wehrend/vocoder-pico-hardware/vocoder-pico-hardware.csv

ID+ADs-Bezeichner+ADs-Footprint+ADs-St+//3//Q-ckzahl+ADs-Bezeichnung+ADs-Anbieter und Referenz
1+ADs-SW2,SW1+ADs-SW+AF8-PUSH+AF8-6mm+ADs-2+ADs-SW+AF8-Push+ADs-
2+ADs-C10+ADs-C+AF8-Disc+AF8-D5.0mm+AF8-W2.5mm+AF8-P5.00mm+ADs-1+ADs-1u+ADs-
3+ADs-R4+ADs-R+AF8-0805+AF8-2012Metric+ADs-1+ADs-6.8k+ADs-
4+ADs-U6,U4,U5,U7+ADs-Sx39+AC0-1xxxxx+ADs-4+ADs-SC39+AC0-11GWA+ADs-
5+ADs-C17,C9,C12,C25+ADs-C+AF8-0805+AF8-2012Metric+ADs-4+ADs-10uF+ADs-
6+ADs-U8+ADs-DIP+AC0-8+AF8-W7.62mm+AF8-Socket+ADs-1+ADs-TL072+ADs-
7+ADs-J3,J2+ADs-Jack+AF8-3.5mm+AF8-QingPu+AF8-WQP+AC0-PJ398SM+AF8-Vertical+AF8-CircularHoles+ADs-2+ADs-AudioJack2+AF8-SwitchT+ADs-
8+ADs-R23,R1,R24+ADs-R+AF8-0805+AF8-2012Metric+ADs-3+ADs-10k+ADs-
9+ADs-C22,C15,C28,C14+ADs-C+AF8-0805+AF8-2012Metric+ADs-4+ADs-0.1uf+ADs-
10+ADs-R7+ADs-R+AF8-0805+AF8-2012Metric+ADs-1+ADs-470Ohm+ADs-
11+ADs-C26+ADs-C+AF8-0805+AF8-2012Metric+ADs-1+ADs-2.2nF+ADs-
12+ADs-U3+ADs-TSSOP+AC0-20+AF8-4.4x6.5mm+AF8-P0.65mm+ADs-1+ADs-PCM5100A+ADs-
13+ADs-RV2,RV1+ADs-Potentiometer+AF8-Alpha+AF8-RD901F+AC0-40+AC0-00D+AF8-Single+AF8-Vertical+ADs-2+ADs-B10K lin+ADs-
14+ADs-R22+ADs-R+AF8-0805+AF8-2012Metric+ADs-1+ADs-1k+ADs-
15+ADs-C19,C20+ADs-C+AF8-0805+AF8-2012Metric+ADs-2+ADs-2.2uf+ADs-
16+ADs-C1,C5,C18,C2+ADs-C+AF8-Disc+AF8-D5.0mm+AF8-W2.5mm+AF8-P5.00mm+ADs-4+ADs-100n+ADs-
17+ADs-C11,C7+ADs-C+AF8-Disc+AF8-D5.0mm+AF8-W2.5mm+AF8-P5.00mm+ADs-2+ADs-100p+ADs-
18+ADs-MK1+ADs-INMP441+AF8-Module+AF8-Socket+ADs-1+ADs-INMP441+AF8-Module+ADs-
19+ADs-R5,R9,R20,R19,R18+ADs-R+AF8-Axial+AF8-DIN0207+AF8-L6.3mm+AF8-D2.5mm+AF8-P7.62mm+AF8-Horizontal+ADs-5+ADs-1k+ADs-
20+ADs-C16+ADs-C+AF8-Disc+AF8-D5.0mm+AF8-W2.5mm+AF8-P5.00mm+ADs-1+ADs-10u+ADs-
21+ADs-U1+ADs-DIP+AC0-8+AF8-W7.62mm+AF8-Socket+ADs-1+ADs-MCP6002+AC0-xP+ADs-
22+ADs-C13+ADs-C+AF8-Disc+AF8-D5.0mm+AF8-W2.5mm+AF8-P5.00mm+ADs-1+ADs-4.7n+ADs-
23+ADs-R21+ADs-R+AF8-0805+AF8-2012Metric+ADs-1+ADs-30k+ADs-
24+ADs-R25+ADs-R+AF8-0805+AF8-2012Metric+ADs-1+ADs-100k+ADs-
25+ADs-U2+ADs-TO+AC0-220+AC0-3+AF8-Vertical+ADs-1+ADs-LM7805+AF8-TO220+ADs-
26+ADs-R17,R13,R14,R16,R11,R10,R12,R15+ADs-R+AF8-Axial+AF8-DIN0207+AF8-L6.3mm+AF8-D2.5mm+AF8-P7.62mm+AF8-Horizontal+ADs-8+ADs-220+ADs-
27+ADs-C6,C3,C4+ADs-CP+AF8-Radial+AF8-D5.0mm+AF8-P2.00mm+ADs-3+ADs-22uF+ADs-
28+ADs-D1,D2,D3+ADs-D+AF8-DO+AC0-41+AF8-SOD81+AF8-P10.16mm+AF8-Horizontal+ADs-3+ADs-1N5817+ADs-
29+ADs-Q3,Q1,Q4,Q2+ADs-TO+AC0-92+AF8-Inline+ADs-4+ADs-BC547+ADs-
30+ADs-J1+ADs-IDC+AC0-Header+AF8-2x05+AF8-P2.54mm+AF8-Vertical+ADs-1+ADs-Conn+AF8-02x05+AF8-Odd+AF8-Even+ADs-
31+ADs-+ADs-female header 1x20 RM2.54+ADs-2+ADs-+ADs-
