wehrend/vocoder-pico-hardware/panel/frontplatte_vorschau.png

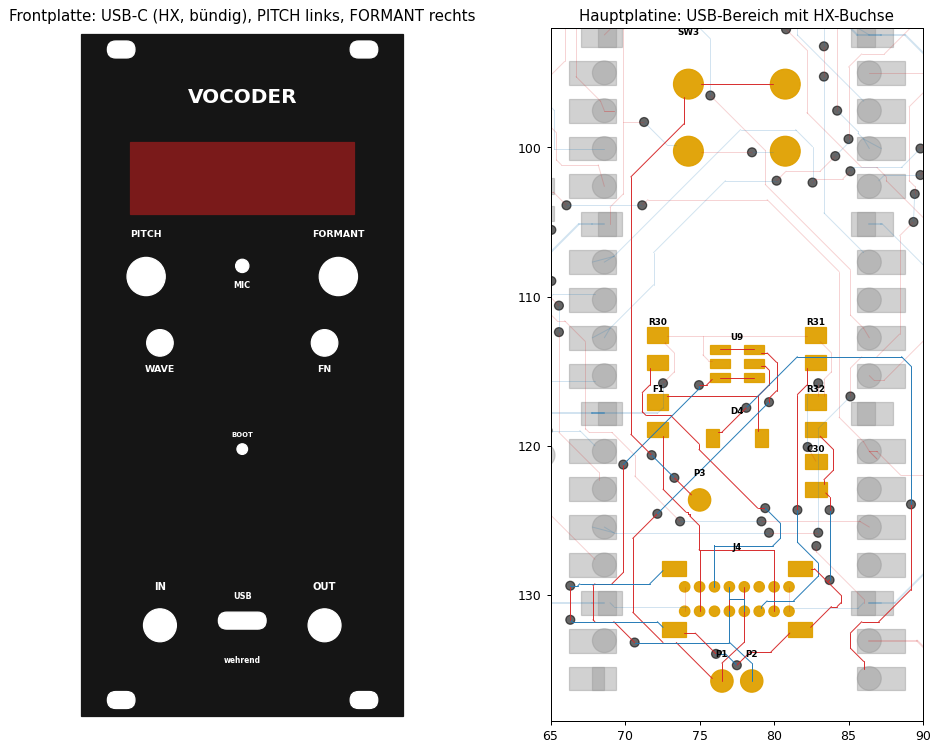
panel/frontplatte_vorschau.png
