wehrend/vocoder-pico-hardware/vocoder-pico-hardware_BOM.xlsx

 |  |  | Vocoder Pico Hardware v1.0 (12HP Eurorack) – BOM per board
Item # | *Designator | *Qty | Manufacturer | *Mfg Part # | Description / Value | *Package/Footprint | Type | Your Instructions / Notes
1 | U3 | 1 | Texas Instruments | PCM5100APWR | IC AUDIO DAC STEREO 32-BIT 384KHZ 2VRMS | TSSOP-20 | SMD | Check pin 1 orientation
2 | C9,C12,C17,C25 | 4 | Samsung | CL21A106KAYNNNE | CAP CER 10UF 25V X5R 0805 | 0805 | SMD | Equivalent X5R/X7R ≥10V acceptable
3 | C14,C15,C22,C28 | 4 | Samsung | CL21B104KBCNNNC | CAP CER 100NF 50V X7R 0805 | 0805 | SMD | Equivalent X7R acceptable
4 | C19,C20 | 2 | Samsung | CL21A225KAFNNNE | CAP CER 2.2UF 25V X5R 0805 | 0805 | SMD | DAC charge pump; equivalent X5R/X7R ≥10V acceptable
5 | C26 | 1 | Samsung | CL21C222JBFNNNE | CAP CER 2.2NF 50V C0G/NP0 0805 | 0805 | SMD | C0G/NP0 required (audio filter)
6 | R1,R23,R24 | 3 | Yageo | RC0805FR-0710KL | RES 10K OHM 1% 1/8W 0805 | 0805 | SMD
7 | R4 | 1 | Yageo | RC0805FR-076K8L | RES 6.8K OHM 1% 1/8W 0805 | 0805 | SMD
8 | R7 | 1 | Yageo | RC0805FR-07470RL | RES 470 OHM 1% 1/8W 0805 | 0805 | SMD
9 | R21 | 1 | Yageo | RC0805FR-0730KL | RES 30K OHM 1% 1/8W 0805 | 0805 | SMD
10 | R22 | 1 | Yageo | RC0805FR-071KL | RES 1K OHM 1% 1/8W 0805 | 0805 | SMD
11 | R25 | 1 | Yageo | RC0805FR-07100KL | RES 100K OHM 1% 1/8W 0805 | 0805 | SMD
12 | C1,C2,C5,C18 | 4 | Vishay | K104K15X7RF53L2 | CAP CER 100NF 50V X7R RADIAL | Radial P5.0mm | thru-hole
13 | C7,C11 | 2 | Vishay | K101J15C0GF53L2 | CAP CER 100PF 50V C0G/NP0 RADIAL | Radial P5.0mm | thru-hole | C0G/NP0 required (op-amp feedback)
14 | C10 | 1 | Murata | RDER71H105K2M1H03A | CAP CER 1UF 50V X7R RADIAL | Radial P5.0mm | thru-hole
15 | C13 | 1 | Vishay | K472K15X7RF53L2 | CAP CER 4.7NF 50V X7R RADIAL | Radial P5.0mm | thru-hole
16 | C16 | 1 | Murata | RDEC71H106K3M1H03A | CAP CER 10UF 50V RADIAL | Radial P5.0mm | thru-hole
17 | C3,C4,C6 | 3 | Panasonic | EEU-FM1H220 | CAP ALUM 22UF 50V RADIAL D5mm | Radial D5.0mm P2.0mm | thru-hole | Polarized – observe + marking; mounted on bottom side
18 | R5,R9,R18,R19,R20 | 5 | Yageo | MFR-25FRF52-1K | RES 1K OHM 1% 1/4W AXIAL METAL FILM | Axial DIN0207 P7.62mm | thru-hole
19 | R10,R11,R12,R13,R14,R15,R16,R17 | 8 | Yageo | MFR-25FRF52-220R | RES 220 OHM 1% 1/4W AXIAL METAL FILM | Axial DIN0207 P7.62mm | thru-hole
20 | D1,D2,D3 | 3 | STMicroelectronics | 1N5817 | DIODE SCHOTTKY 20V 1A DO-41 | DO-41 P10.16mm | thru-hole | Polarized – cathode band per silkscreen; mounted on bottom side
21 | Q1,Q2,Q3,Q4 | 4 | onsemi | BC547BTF | TRANS NPN 45V 100MA TO-92 | TO-92 inline | thru-hole | Mounted on bottom side; pinout C-B-E
22 | U2 | 1 | STMicroelectronics | L7805CV | IC REG LINEAR 5V 1.5A TO-220 | TO-220-3 vertical | thru-hole | Mounted on bottom side
23 | SW1,SW2 | 2 | Omron | B3F-1060 | SWITCH TACTILE SPST-NO 6X6MM | 6x6mm THT | thru-hole | Actuator height must suit front panel (cap)
24 | U4,U5,U6,U7 | 4 | Kingbright | SC39-11SURKWA | DISPLAY 7-SEG 1 DIGIT 10MM HYPER RED CC | Sx39-1xxxxx | thru-hole
25 | J1 | 1 | Würth Elektronik | 61201021621 | CONN BOX HEADER 2X5 2.54MM VERTICAL | IDC 2x05 P2.54mm | thru-hole | Eurorack power; mounted on bottom side; -12V at pin 1 (silkscreen)
26 | H3,H4 | 2 | Mill-Max | 110-43-308-41-001000 | SOCKET IC DIP-8 PRECISION | DIP-8 W7.62mm | thru-hole | DIP-8 sockets; no own footprint – solder into U1/U8 positions
27 | U1 | 1 | Microchip | MCP6002-I/P | IC OPAMP DUAL RAIL-TO-RAIL 1MHZ DIP-8 | DIP-8 | thru-hole | Insert into socket, do not solder
28 | U8 | 1 | Texas Instruments | TL072CP | IC OPAMP DUAL JFET DIP-8 | DIP-8 | thru-hole | Insert into socket, do not solder
29 | H1,H2 | 2 | generic | Female header 1x20 RM2.54 | CONN FEMALE HEADER 1X20 2.54MM VERTICAL | 1x20 P2.54mm | thru-hole | Two 1x20 female headers, one per pin row of A1 (Pico socket); no own footprint – solder into A1 pin rows
30 | J2,J3 | 2 | Thonk / QingPu | WQP-PJ398SM | JACK 3.5MM MONO SWITCHED VERTICAL (Thonkiconn) | PJ398SM vertical | thru-hole | Align with front panel before soldering
31 | RV1,RV2 | 2 | Alpha | RD901F-40 B10K | POT 9MM VERTICAL 10K LINEAR, M7 BUSHING | Alpha RD901F-40-00D | thru-hole | Shaft type to match knobs; align with front panel before soldering
32 | MK1 | 1 | generic | INMP441 breakout module | I2S MEMS MICROPHONE MODULE | INMP441 module 2x3 | thru-hole | Sound port side facing front panel
33 | J4 | 1 | Hanxia | HX-TYPE-C 16P 180 LC-B H10.0 | CONN USB-C RECEPTACLE 16P VERTICAL THT H10mm (LCSC C49261584) | USB-C vertical THT | thru-hole | Front side, bottom centre; opening towards front panel
34 | U9 | 1 | STMicroelectronics | USBLC6-2SC6 | TVS DIODE ARRAY ESD USB 2 LINES | SOT-23-6 | SMD | Check pin 1 orientation
35 | D4 | 1 | onsemi | MBR0520LT1G | DIODE SCHOTTKY 20V 0.5A | SOD-123 | SMD | Polarized – cathode band per silkscreen
36 | F1 | 1 | Bourns | MF-PSMF050X-2 | PTC RESETTABLE FUSE 0.5A HOLD | 0805 | SMD | Equivalent 0805 PTC 0.5A hold acceptable
37 | R30,R31 | 2 | Yageo | RC0805FR-075K1L | RES 5.1K OHM 1% 1/8W 0805 | 0805 | SMD | USB-C CC pull-downs
38 | R32 | 1 | Yageo | RC0805FR-071ML | RES 1M OHM 1% 1/8W 0805 | 0805 | SMD
39 | C30 | 1 | Samsung | CL21B472KBANNNC | CAP CER 4.7NF 50V X7R 0805 | 0805 | SMD | Equivalent X7R acceptable
40 | SW3 | 1 | Omron | B3F-1060 | SWITCH TACTILE SPST-NO 6X6MM (BOOTSEL) | 6x6mm THT | thru-hole | Pressed through small front panel hole
41 | P1,P2,P3 | 3 | generic | P50 spring probe | SPRING TEST PROBE P50, ROUND/FLAT HEAD | Ø0.68mm probe | thru-hole | Inserted into R50 receptacles; must reach Pico test pads TP2/TP3/TP6 (~11 mm)
42 | H5,H6,H7 | 3 | generic | R50 receptacle | RECEPTACLE FOR P50 PROBE | Ø1.0mm hole | thru-hole | No own footprint – solder into P1–P3, bottom side
43 | A1 | 1 | Raspberry Pi | Raspberry Pi Pico H | MICROCONTROLLER MODULE RP2040 WITH HEADERS | Pico module | DNS | Do not stuff – plugged into female headers by customer
Need a quick and accurante quote? Need an efficient production? Please read SMT Ordering Necessary Files & Info in 1 minute. Thank you very much! (https://www.pcbway.com/smt_ordering_guide.html)
Click for Instructions on How to Create a BOM (https://www.pcbway.com/blog/PCB_Assembly/How_to_Build_a_BOM__Bill_Of_Materials_.html)
