wehrend/vocoder-pico-hardware/vocoder-pico-hardware.kicad_pcb

## KiCad design vocoder-pico-hardware.kicad_pcb (2026-10-19)

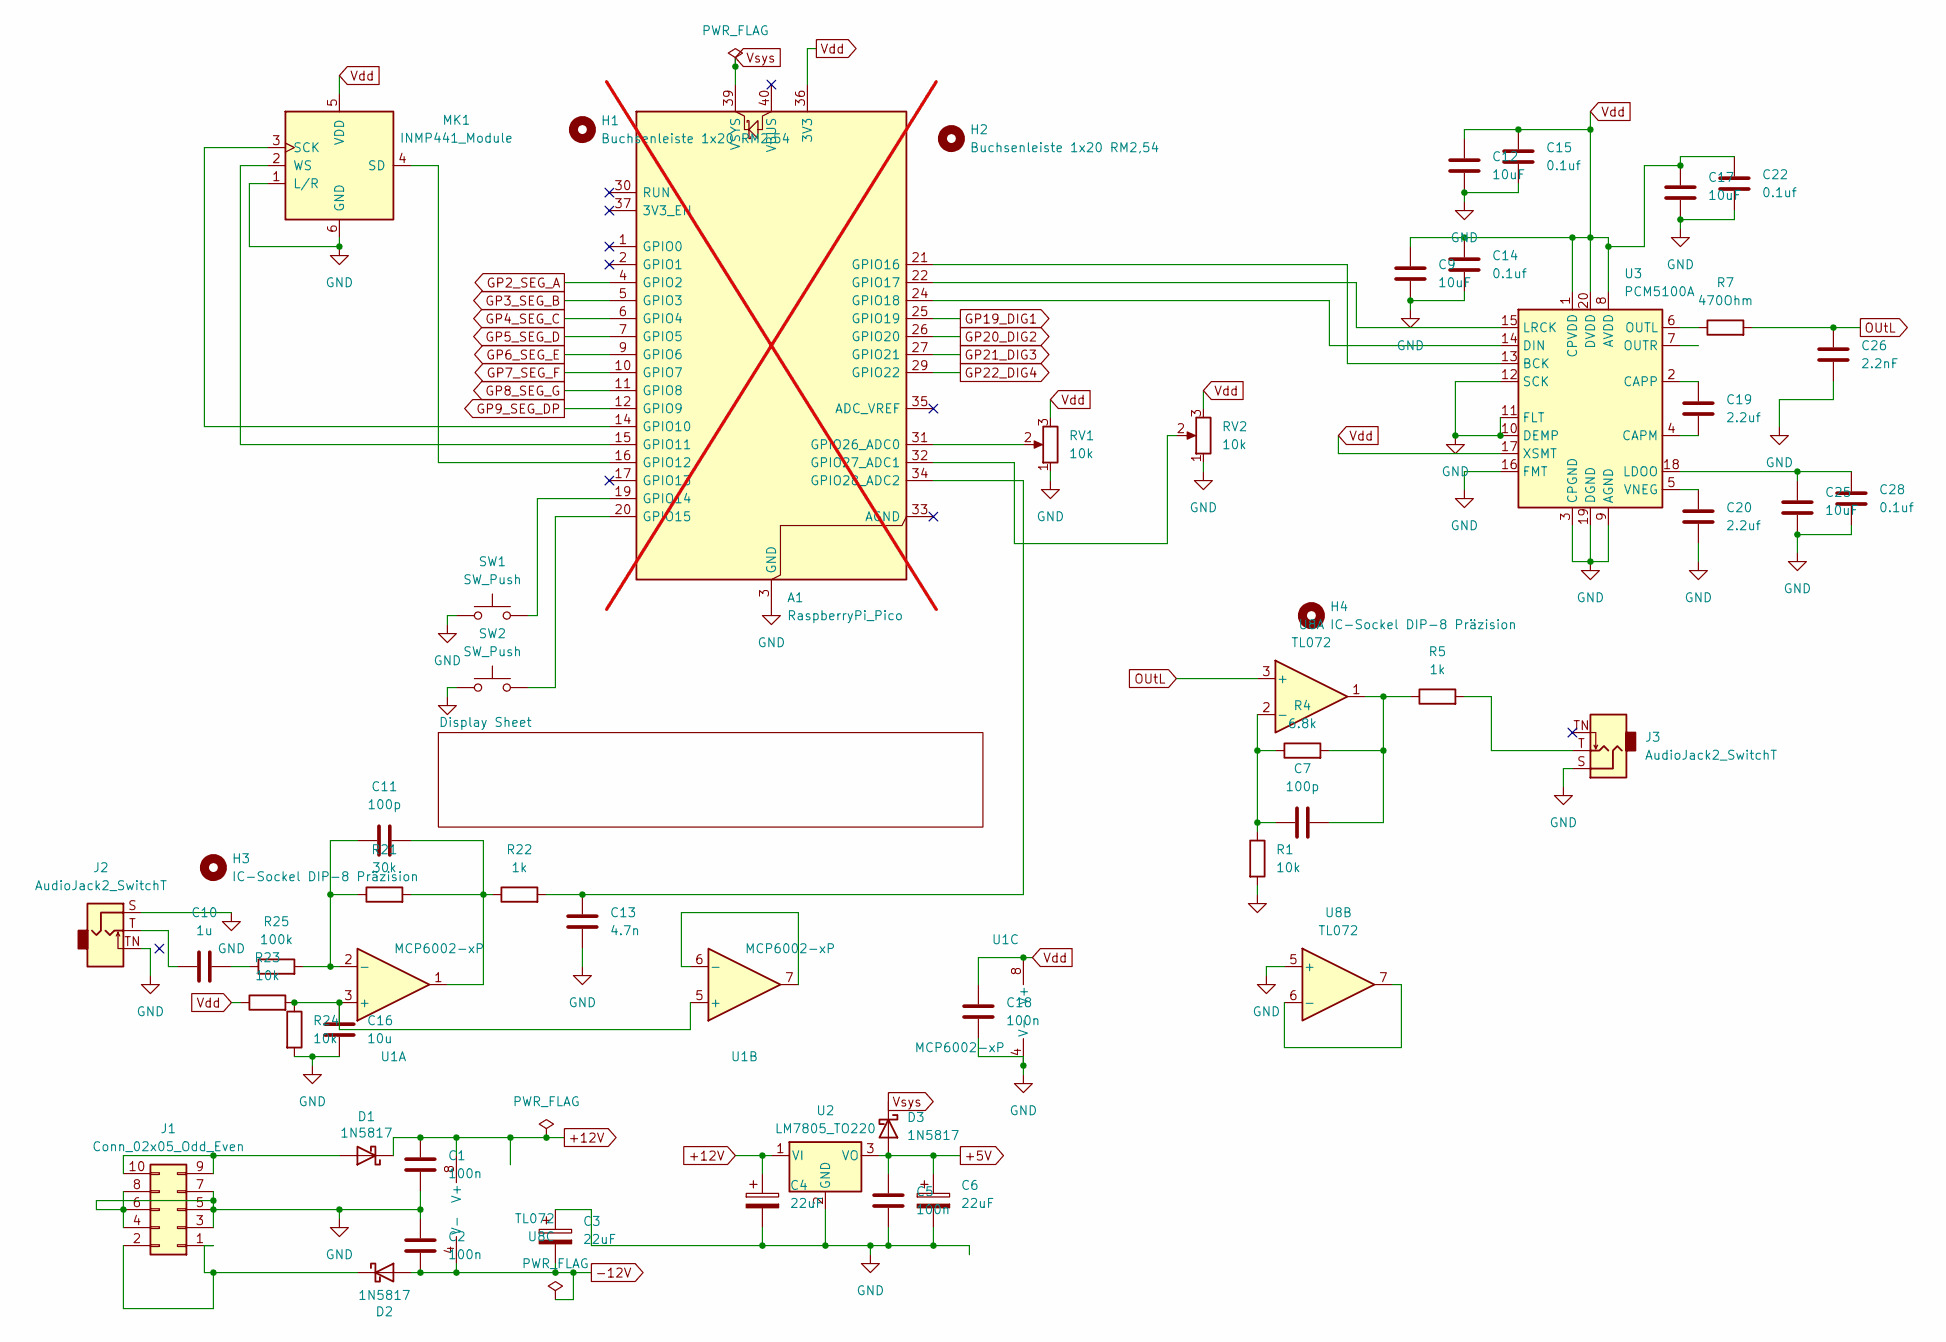
[picture p2: schematic vocoder-pico-hardware.kicad_sch]

Parts:
A1: RaspberryPi_Pico; RaspberryPi_Pico_Common_Unspecified; not fitted
C1, C2, C5, C18: 100n; C_Disc_D5.0mm_W2.5mm_P5.00mm
C3, C4, C6: 22uF; CP_Radial_D5.0mm_P2.00mm
C7, C11: 100p; C_Disc_D5.0mm_W2.5mm_P5.00mm
C9, C12, C17, C25: 10uF; C_0805_2012Metric
C10: 1u; C_Disc_D5.0mm_W2.5mm_P5.00mm
C13: 4.7n; C_Disc_D5.0mm_W2.5mm_P5.00mm
C14, C15, C22, C28: 0.1uf; C_0805_2012Metric
C16: 10u; C_Disc_D5.0mm_W2.5mm_P5.00mm
C19, C20: 2.2uf; C_0805_2012Metric
C26: 2.2nF; C_0805_2012Metric
D1, D2, D3: 1N5817; D_DO-41_SOD81_P10.16mm_Horizontal
H1, H2: Buchsenleiste 1x20 RM2,54
H3, H4: IC-Sockel DIP-8 Präzision
J1: Conn_02x05_Odd_Even; IDC-Header_2x05_P2.54mm_Vertical
J2, J3: AudioJack2_SwitchT; Jack_3.5mm_QingPu_WQP-PJ398SM_Vertical_CircularHoles
MK1: INMP441_Module; INMP441_Module_Socket
R1, R23, R24: 10k; R_0805_2012Metric
R4: 6.8k; R_0805_2012Metric
R5: 1k; R_Axial_DIN0207_L6.3mm_D2.5mm_P7.62mm_Horizontal
R7: 470Ohm; R_0805_2012Metric
R21: 30k; R_0805_2012Metric
R22: 1k; R_0805_2012Metric
R25: 100k; R_0805_2012Metric
RV1, RV2: 10k; Potentiometer_Alpha_RD901F-40-00D_Single_Vertical
SW1, SW2: SW_Push; SW_PUSH_6mm
U1: MCP6002-xP; DIP-8_W7.62mm_Socket
U2: LM7805_TO220; TO-220-3_Vertical
U3: PCM5100A; TSSOP-20_4.4x6.5mm_P0.65mm
U8: TL072; DIP-8_W7.62mm_Socket

Connections:
+5V: C5.1, C6.1, D3.2 (A), U2.3 (VO)
+12V: C1.1, C4.1, D1.1 (K), U2.1 (VI), U8.8 (V+)
-12V: C2.2, C3.2, D2.2 (A), U8.4 (V-)
GND: A1.3 (GND), A1.8 (GND), A1.13 (GND), A1.18 (GND), A1.23 (GND), A1.28 (GND), A1.38 (GND), C1.2, C2.1, C3.1, C4.2, C5.2, C6.2, C9.2, C12.2, C13.2, C14.2, C15.2, C16.2, C17.2, C18.2, C20.2, C22.2, C25.2, C26.2, C28.2, J1.3, J1.4, J1.5, J1.6, J1.7, J1.8, J2.S, J2.TN, J3.S, MK1.1 (L/R), MK1.6 (GND), R1.2, R24.2, RV1.1, RV2.1, SW1.1, SW2.1, U1.4 (V-), U2.2 (GND), U3.3 (CPGND), U3.9 (AGND), U3.10 (DEMP), U3.11 (FLT), U3.12 (SCK), U3.16 (FMT), U3.19 (DGND), U8.5 (+); also elsewhere on the board
GP2_SEG_A: A1.4 (GPIO2); also elsewhere on the board
GP3_SEG_B: A1.5 (GPIO3); also elsewhere on the board
GP4_SEG_C: A1.6 (GPIO4); also elsewhere on the board
GP5_SEG_D: A1.7 (GPIO5); also elsewhere on the board
GP6_SEG_E: A1.9 (GPIO6); also elsewhere on the board
GP7_SEG_F: A1.10 (GPIO7); also elsewhere on the board
GP8_SEG_G: A1.11 (GPIO8); also elsewhere on the board
GP9_SEG_DP: A1.12 (GPIO9); also elsewhere on the board
GP19_DIG1: A1.25 (GPIO19); also elsewhere on the board
GP20_DIG2: A1.26 (GPIO20); also elsewhere on the board
GP21_DIG3: A1.27 (GPIO21); also elsewhere on the board
GP22_DIG4: A1.29 (GPIO22); also elsewhere on the board
unnamed: A1.14 (GPIO10), MK1.3 (SCK)
unnamed: A1.15 (GPIO11), MK1.2 (WS)
unnamed: A1.16 (GPIO12), MK1.4 (SD)
unnamed: A1.19 (GPIO14), SW1.2
unnamed: A1.20 (GPIO15), SW2.2
unnamed: A1.21 (GPIO16), U3.13 (BCK)
unnamed: A1.22 (GPIO17), U3.15 (LRCK)
unnamed: A1.24 (GPIO18), U3.14 (DIN)
unnamed: A1.31 (GPIO26_ADC0), RV1.2
unnamed: A1.32 (GPIO27_ADC1), RV2.2
unnamed: A1.34 (GPIO28_ADC2), C13.1, R22.2
unnamed: C7.2, R4.2, R5.1, U8.1
unnamed: C10.1, J2.T
unnamed: C10.2, R25.1
unnamed: C11.2, R21.2, R22.1, U1.1
unnamed: D1.2 (A), J1.9, J1.10
unnamed: D2.1 (K), J1.1, J1.2
unnamed: J3.T, R5.2
unnamed: C16.1, R23.2, R24.1, U1.3 (+), U1.5 (+)
unnamed: C11.1, R21.1, R25.2, U1.2 (-)
unnamed: U1.6 (-), U1.7
unnamed: C19.2, U3.4 (CAPM)
unnamed: C19.1, U3.2 (CAPP)
unnamed: C25.1, C28.1, U3.18 (LDOO)
unnamed: R7.1, U3.6 (OUTL)
unnamed: C20.1, U3.5 (VNEG)
unnamed: C7.1, R1.1, R4.1, U8.2 (-)
unnamed: U8.6 (-), U8.7
OUtL: C26.1, R7.2, U8.3 (+)
Vdd: A1.36 (3V3), C9.1, C12.1, C14.1, C15.1, C17.1, C18.1, C22.1, MK1.5 (VDD), R23.1, RV1.3, RV2.3, U1.8 (V+), U3.1 (CPVDD), U3.8 (AVDD), U3.17 (XSMT), U3.20 (DVDD)
Vsys: A1.39 (VSYS), D3.1 (K)

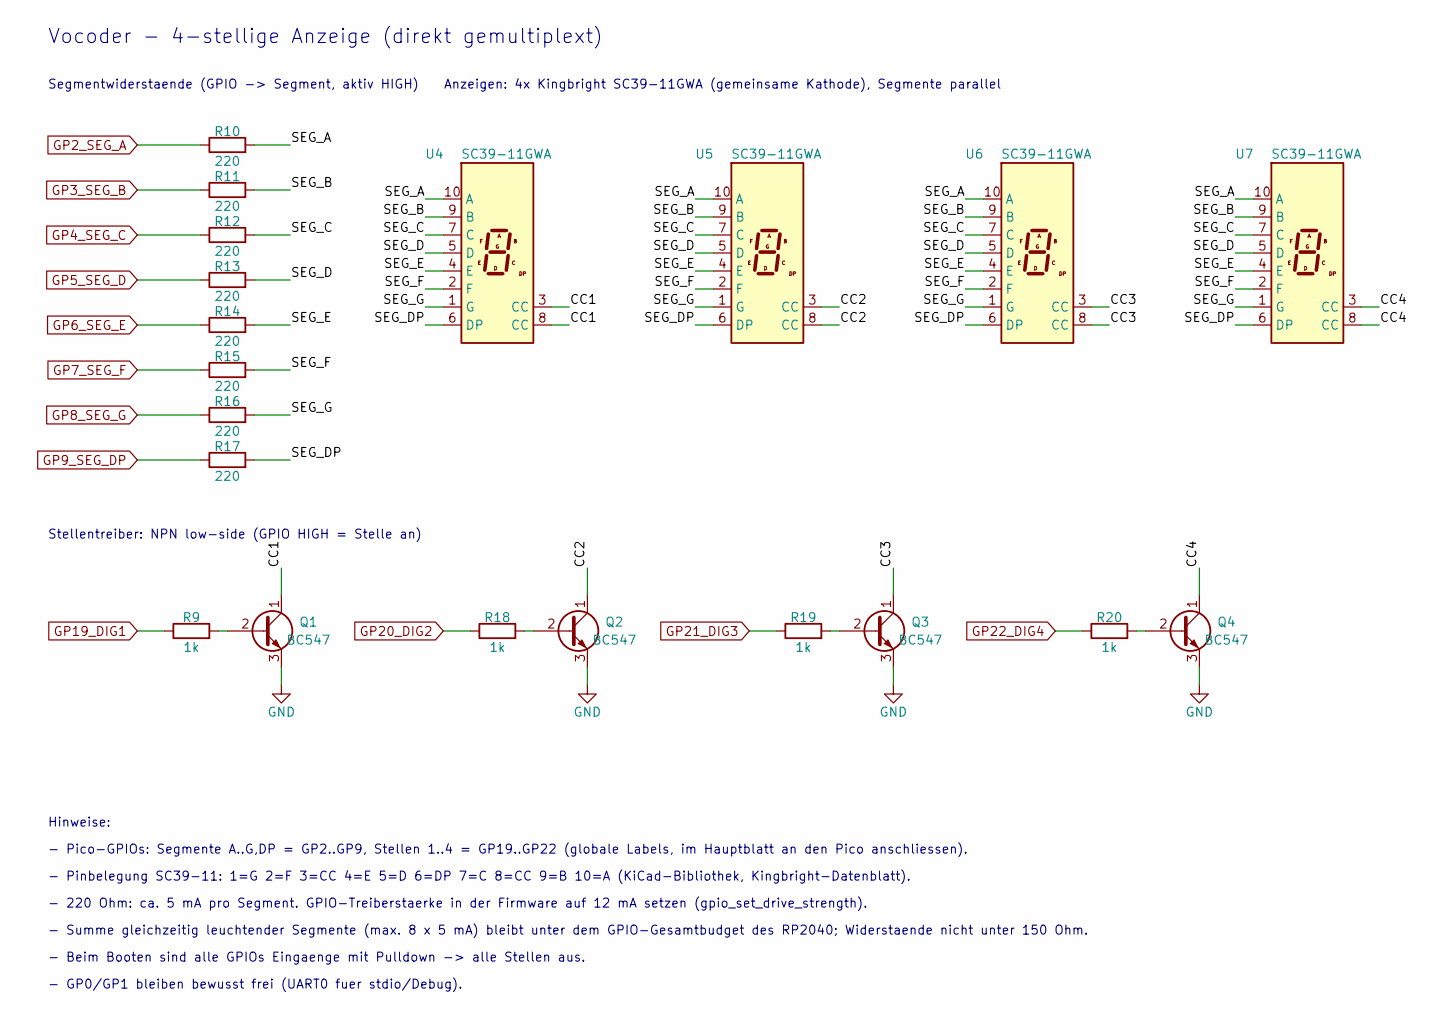
[picture p3: schematic display.kicad_sch, Vocoder Display]

Parts:
Q1, Q2, Q3, Q4: BC547; TO-92_Inline
R9, R18, R19, R20: 1k; R_Axial_DIN0207_L6.3mm_D2.5mm_P7.62mm_Horizontal
R10, R11, R12, R13, R14, R15, R16, R17: 220; R_Axial_DIN0207_L6.3mm_D2.5mm_P7.62mm_Horizontal
U4, U5, U6, U7: SC39-11GWA; Sx39-1xxxxx

Connections:
/Display Sheet/CC1: Q1.1 (C), U4.3 (CC), U4.8 (CC)
/Display Sheet/CC2: Q2.1 (C), U5.3 (CC), U5.8 (CC)
/Display Sheet/CC3: Q3.1 (C), U6.3 (CC), U6.8 (CC)
/Display Sheet/CC4: Q4.1 (C), U7.3 (CC), U7.8 (CC)
/Display Sheet/SEG_A: R10.2, U4.10 (A), U5.10 (A), U6.10 (A), U7.10 (A)
/Display Sheet/SEG_B: R11.2, U4.9 (B), U5.9 (B), U6.9 (B), U7.9 (B)
/Display Sheet/SEG_C: R12.2, U4.7 (C), U5.7 (C), U6.7 (C), U7.7 (C)
/Display Sheet/SEG_D: R13.2, U4.5 (D), U5.5 (D), U6.5 (D), U7.5 (D)
/Display Sheet/SEG_DP: R17.2, U4.6 (DP), U5.6 (DP), U6.6 (DP), U7.6 (DP)
/Display Sheet/SEG_E: R14.2, U4.4 (E), U5.4 (E), U6.4 (E), U7.4 (E)
/Display Sheet/SEG_F: R15.2, U4.2 (F), U5.2 (F), U6.2 (F), U7.2 (F)
/Display Sheet/SEG_G: R16.2, U4.1 (G), U5.1 (G), U6.1 (G), U7.1 (G)
GND: Q1.3 (E), Q2.3 (E), Q3.3 (E), Q4.3 (E); also elsewhere on the board
GP2_SEG_A: R10.1; also elsewhere on the board
GP3_SEG_B: R11.1; also elsewhere on the board
GP4_SEG_C: R12.1; also elsewhere on the board
GP5_SEG_D: R13.1; also elsewhere on the board
GP6_SEG_E: R14.1; also elsewhere on the board
GP7_SEG_F: R15.1; also elsewhere on the board
GP8_SEG_G: R16.1; also elsewhere on the board
GP9_SEG_DP: R17.1; also elsewhere on the board
GP19_DIG1: R9.1; also elsewhere on the board
GP20_DIG2: R18.1; also elsewhere on the board
GP21_DIG3: R19.1; also elsewhere on the board
GP22_DIG4: R20.1; also elsewhere on the board
unnamed: Q1.2 (B), R9.2
unnamed: Q2.2 (B), R18.2
unnamed: Q3.2 (B), R19.2
unnamed: Q4.2 (B), R20.2

Notes on the sheet:
- Beim Booten sind alle GPIOs Eingaenge mit Pulldown -> alle Stellen aus.
- Pinbelegung SC39-11: 1=G 2=F 3=CC 4=E 5=D 6=DP 7=C 8=CC 9=B 10=A (KiCad-Bibliothek, Kingbright-Datenblatt).
Stellentreiber: NPN low-side (GPIO HIGH = Stelle an)
- Summe gleichzeitig leuchtender Segmente (max. 8 x 5 mA) bleibt unter dem GPIO-Gesamtbudget des RP2040; Widerstaende nicht unter 150 Ohm.
- 220 Ohm: ca. 5 mA pro Segment. GPIO-Treiberstaerke in der Firmware auf 12 mA setzen (gpio_set_drive_strength).
- Pico-GPIOs: Segmente A..G,DP = GP2..GP9, Stellen 1..4 = GP19..GP22 (globale Labels, im Hauptblatt an den Pico anschliessen).
Segmentwiderstaende (GPIO -> Segment, aktiv HIGH)
Vocoder - 4-stellige Anzeige (direkt gemultiplext)
- GP0/GP1 bleiben bewusst frei (UART0 fuer stdio/Debug).
Anzeigen: 4x Kingbright SC39-11GWA (gemeinsame Kathode), Segmente parallel
Hinweise:

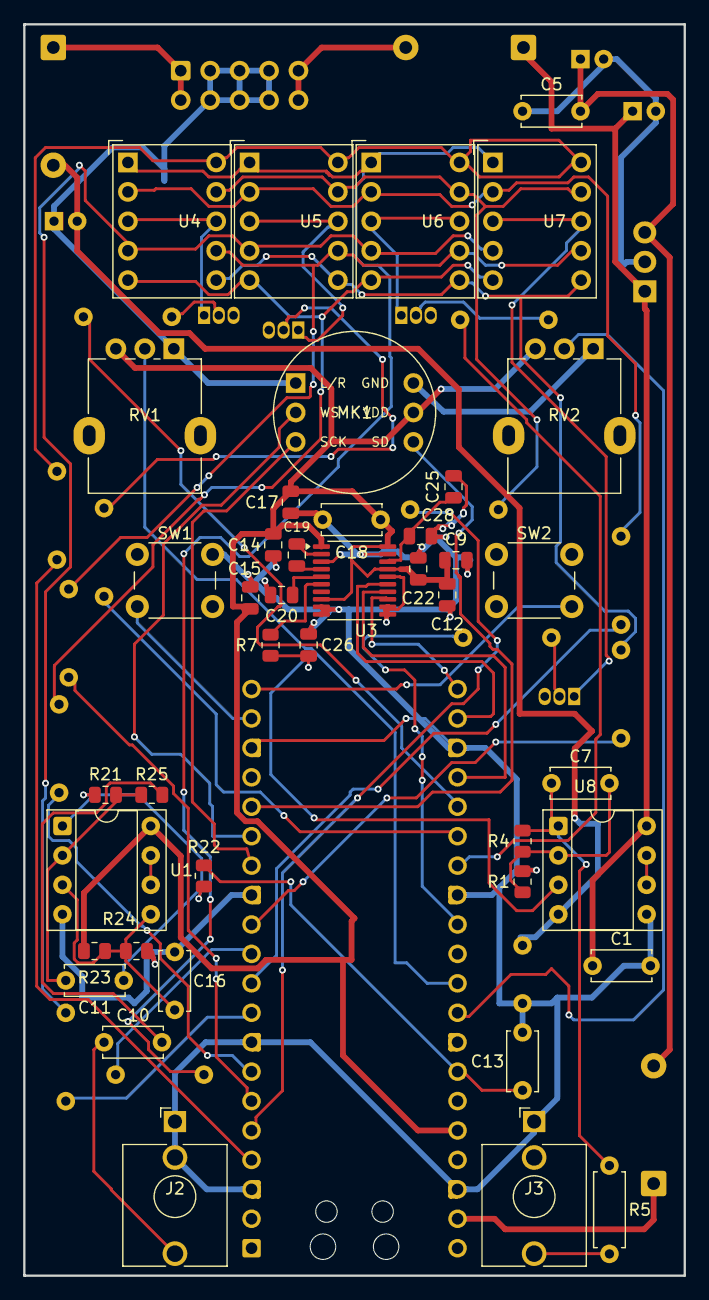
[picture p4: board vocoder-pico-hardware.kicad_pcb from above]

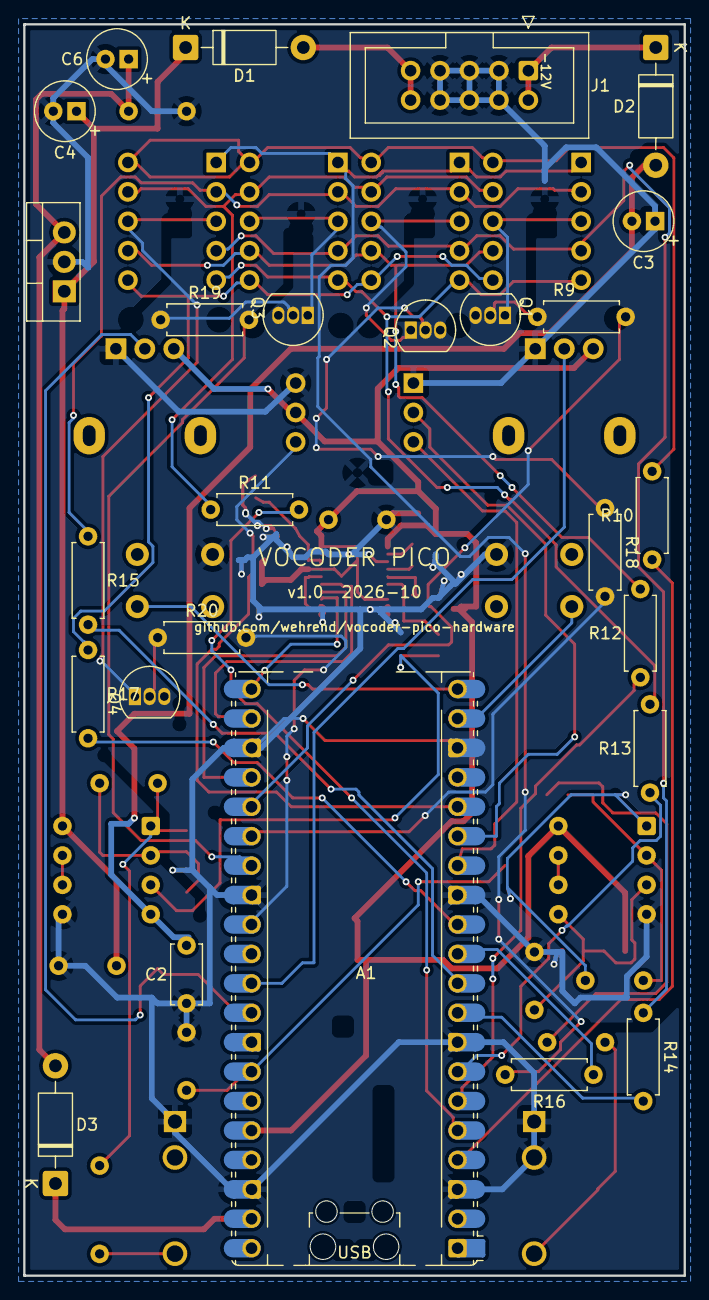
[picture p5: board vocoder-pico-hardware.kicad_pcb from below]

Board: 2 copper layers, 57.0 x 108.0 mm, 68 parts (26 on the bottom side), 63 nets.
