wehrend/vocoder-pico-hardware/(commit log)

2026-10-09 add output amplifier
    [vocoder-pico-hardware.kicad_sch]
2026-10-09 add power supply
    [vocoder-pico-hardware.kicad_sch]
2026-10-09 fix errors in power supply
    [vocoder-pico-hardware.kicad_sch]
2026-10-09 improve power supply
    [vocoder-pico-hardware.kicad_sch]
2026-10-09 correcting ic numbers
    [vocoder-pico-hardware.kicad_sch]
2026-10-09 reset annotations
    [display.kicad_sch, vocoder-pico-hardware.kicad_sch]
2026-10-09 remove duplicates
    [vocoder-pico-hardware.kicad_sch]
2026-10-09 implement input stage
    [vocoder-pico-hardware.kicad_sch]
2026-10-09 implement inmp441 module
    [vocoder-pico-hardware.kicad_pcb, vocoder-pico-hardware.kicad_sch]
2026-10-10 add footprints and erc check
    [vocoder-pico-hardware.kicad_pcb, vocoder-pico-hardware.kicad_sch]
2026-10-10 add not connected crosses
    [vocoder-pico-hardware.kicad_sch]
2026-10-10 finish footprints assignment
    [vocoder-pico-hardware.kicad_sch]
2026-10-10 add footprints for capacitors
    [vocoder-pico-hardware.kicad_sch]
2026-10-10 more fixes for jacks and footprints
    [vocoder-pico-hardware.kicad_pcb, vocoder-pico-hardware.kicad_sch]
2026-10-10 final fixes
    [vocoder-pico-hardware.kicad_sch]
2026-10-10 fix wrong symbol
    [vocoder-pico-hardware.kicad_sch]
2026-10-10 run erc checks and added fixes
    [vocoder-pico-hardware.kicad_sch]
2026-10-10 adding edge.cuts and placing components
    [vocoder-pico-hardware.kicad_pcb, vocoder-pico-hardware.kicad_sch]
2026-10-10 placing all components
    [vocoder-pico-hardware.kicad_pcb]
2026-10-10 replace certain resistor with 0805
    [vocoder-pico-hardware.kicad_pcb, vocoder-pico-hardware.kicad_sch]
2026-10-10 replace certain capacitors with 0805
    [vocoder-pico-hardware.kicad_pcb, vocoder-pico-hardware.kicad_sch]
2026-10-10 rerun to prevent overlaps
    [vocoder-pico-hardware.kicad_pcb]
2026-10-10 cosmetic changes
    [vocoder-pico-hardware.kicad_pcb]
2026-10-10 configure net classes
    [vocoder-pico-hardware.kicad_pcb]
2026-10-11 update footprints
2026-10-11 make polarized capacitators consistent
2026-10-11 begin power supply routing
2026-10-11 continue power supply routing / relocate D3
2026-10-11 improve power supply placement and routing
2026-10-11 finalize power supply placement and routing
2026-10-12 replacing jacks to the bottom of the pcb
2026-10-12 repossitioning smd resistors
2026-10-12 repositioning smd resistors
2026-10-12 remove antenna keep out area
2026-10-12 finalize routing of output stage / section
2026-10-12 finalize routing input stage section
2026-10-12 routing for potis and buttons
2026-10-12 rerouting power section
2026-10-13 apply ground plane on the back side
2026-10-13 update schematic
2026-10-13 remove the pico module from bom
2026-10-13 add female header for the pico
2026-10-13 add sockets for U1 and U8
2026-10-15 reconnect cutted ground plane
2026-10-24 implement usb socket
2026-10-31 add BoM for pcbway
